kitty-violet/efinix-romantic-camera/THIRD_PARTY_NOTICES.md

# 第三方组件与权利说明

## 当前交付范围

本仓库按所有者要求公开归档指定 r15 complete 代码、模型/权重、运行数据、开发来源与 V9-P1 机械资料，供评审查阅。未自动套用 MIT、Apache-2.0、GPL、CERN-OHL 等统一许可证；公开访问不等同于取得所有内容的再分发或商用授权。

团队自研 HDL、机械设计和文档的权利范围由实际权利人确定。当前未提供全体作者授权或明确开源许可证，因此本仓库不代为作出开源授权声明。

## Efinix 器件原语和 IP

`fpga/project/native222.v` 是 r15 顶层网表，文件中带有 Efinity 2026.1.132 属性、Efinix 器件原语和 `pragma protect` 保护段；`five_style_name_osd.sv` 使用 `EFX_DPRAM10`。综合/仿真用 Sapphire 核及 `tests/vendor/efx_dsp48.v` 也按原包保留其厂家声明和保护内容。

受保护内容和厂家器件库适用其原有权利与许可条件。归档未解密、剥离或改写保护段，不把厂家 IP 改标为团队开源代码。使用者需自行具备合法的 Efinity/Titanium 工具与相应 IP 使用权限。

## I2C 源文件声明

r15 的 `i2c_master_bit_ctrl.v`、`i2c_master_byte_ctrl.v`、`i2c_master_defines.v` 同时带有 Intel 许可提示和 Richard Herveille/OpenCores 原始版权声明。本次逐字节保留这些文件及声明，不将它们改标为团队原创，也不为其添加统一开源授权。

## 机械设计来源记录

V9 参数和孔位报告引用板卡装配图、板卡设计说明、蓝牙模块资料及团队提供的照片/实测。引用信息保留于 CAD 参数和原始报告；相关厂家完整资料与竞赛 PDF 未整包上传。

原 CAD 生成脚本依赖 CadQuery、OCP 和 NumPy，但本仓库只包含项目脚本，不分发这些软件的安装文件或运行环境。它们分别适用自身许可证。

## 模型及开发来源

`fpga/network/`含团队选定五风格模型、量化参数、可读计算核和运行数据；`fpga/original_sources/`保留训练、导出和集成脚本的历史目录及声明。PyTorch、NumPy、Pillow 等依赖本体未分发，适用各自许可证。来源映射和哈希保留于 `fpga/SOURCE_ORIGINS.json`与各风格元数据。

## 公开与后续使用

本次仅按所有者要求变更仓库可见性，不为第三方代码、受保护 IP、模型素材或其他作者的作品新增授权。团队后续选定自研文件许可证时，应明确适用范围并继续保留第三方声明；更改可见性本身也不代表构建、板上验收或比赛申报已完成。
