kitty-violet/efinix-romantic-camera/docs/competition-checklist.md

# 赛题要求与本版本对照

核对日期：2026-11-04。当前归档：production-r15-complete（原包日期 2026-11-03）。此前“无 RISC-V、仅四个 HDL”的描述只适用于历史提交 `423d07a`，不再用于本版本。

依据团队已有《全国大学生嵌入式芯片与系统设计竞赛'2026 FPGA 创新设计赛道选题指南（易灵思）》共 21 页，平台说明见 PDF 第 3-4 页，赛题一“AI 赋能的「实时绘画」——风格化视频渲染系统”见 PDF 第 4-7 页。本次没有把厂家/组委会整份 PDF 复制到仓库，也没有用未经确认的网络规则替代本地版本。

“原说明记录”表示来源包中的声明；“源码可见”只表示阅读能确认的实现；“未提供”表示缺少材料或实测证据。本轮重新执行文件、工程引用、ROM、整数参数/参考向量、描述符及运行数据内存重建校验，没有执行训练、综合、HDL 仿真或实板测试。包内 PyTorch 和 Questa 检查结果是来源记录。

## 基础要求

| 赛题条目 | 当前仓库情况 | 提交/复现所需材料 |
| --- | --- | --- |
| Ti60F225 平台 | 工程 XML 指定 Ti60F225、I3、`ti60f225_oob_top`，已附引脚/外设/SDC | 实际板型、接线与构建实测记录 |
| MIPI CSI-2、SC431HAI、RAW 转 RGB/Resize，至少 640×480@30fps | 已附相机配置表、C 初始化、I2C 服务和图像路径/缩放逻辑 | 传感器/输入时序与采集速率实测 |
| DDR Ping-Pong 不丢帧 | 已附帧所有权、DDR 读写/DMA 和跨域源码 | 缓冲设计图、持续流量及掉帧测试 |
| 3×3/5×5 卷积、激活、BN/IN 近似硬件 | 已附 S4R1 逐层结构、3×3/DW/PW、ReLU、残差/重定量及 42 个可读核设计源；当前网络并无独立 BN/IN 或 5×5 节点 | 按正式评分口径说明算子/归一化映射，补功能仿真与综合证据；不将量化直接等同于 BN/IN |
| 总线访问 DDR 完成推理读写 | 已附 `control.h`、服务后端、DMA 和 C 调度 | 完整总线/地址图、带宽及端到端推理验证 |
| HDMI 至少 720p60 或 1080p30 | 源码时序 2200×1125、74.25MHz，对应 1080p30；风格计算为 720p，并非 HDMI30 即 AI30 | 本版输出时序、兼容性与稳定性实测 |
| RISC-V C 驱动完成相机初始化、权重加载、任务调度/中断 | **已新增官方 Sapphire 核、C 相机配置、目录/CRC 校验、装载调度与中断处理源码** | 对应生产 Flash 数据、固件/位流版本和实板运行证据 |
| 原图/风格图对比或按键切换 | 原包说明六模式、全半屏；源码有视图事件和原始/缩放路径切换 | 实际视图布局、操作与对比录像 |
| 实时 FPS，640×480 稳定 15fps 以上 | 有 FPS 显示相关逻辑，未附 r15 指定条件的帧率测量 | 分辨率、窗口、计数口径明确的实测；旧版 17.1 FPS 不直接复用 |

## 高阶挑战

| 赛题条目 | 当前仓库情况 | 需要补充 |
| --- | --- | --- |
| 至少两套网络权重，动态切换，不重配 FPGA | 五套独立 checkpoint/整数权重及六槽目录已附，C 支持驻留与切换；第六槽为原图 bypass，不是独立 CNN | 匹配位流和数据区、实际动态切换验收 |
| 切换延迟低于 100ms，切换不丢帧 | C 先排空再准备/恢复，原包称 r15 使用 16 支模式控制缓冲；无延迟实测 | 同步触发与输出的测量记录 |
| 1280×720@30fps 或更高处理吞吐 | 没有本版测量结果，不能据逻辑时钟或 HDMI 时序宣称 AI 吞吐 | r15 吞吐、延迟与稳定性数据 |
| 小于 500KB 网络、结构图、参数量表 | 已附逐层结构/连接表和参数表；每风格 4035 参数，checkpoint 28,519B，整数系数 5708B，驻留布局 20,480B | 注明统计是否含量化元数据/调度程序，补正式报告图及精度证据；程序大小不混作网络权重 |
| 对照标准网络的 PSNR/SSIM、推理延迟 | 未提供 | 数据集、评估脚本、指标和对比口径 |
| 创意交互及附加展示视频 | 有 BLE/按键事件、中文 OSD 和全半屏控制源码；无 APK/视频 | 手机控制演示、协议/应用版本及运行录像 |

r15 已有 RISC-V、工程配置、模型/可读核和运行数据，相应材料缺项已解除；数据区来源仍标记未板验，且没有最终位流。源码齐备和引用正确不能替代构建/性能验收。V9 外壳继续原样保留，其历史数值检查不等同于实物打印验收。

## GitHub 与评审访问

前次阅读的本地易灵思选题指南和总赛题指南中未找到“必须公开 GitHub 仓库”的明确条款；本次**按仓库所有者明确要求改为公开**，供评委直接查看，而非推定比赛条款。具体比赛平台的链接字段、报告和视频要求仍以团队收到的正式提交说明为准。

公开入口：`https://github.com/kitty-violet/efinix-romantic-camera`。浏览和克隆不再需要邀请；写入与管理权限仍受 GitHub 权限控制。公开不代表重新许可厂商受保护 IP，原版权和保护段保持不变。

建议准备的材料和当前缺项见[交接与提交](submission.md)。本表是一份依据已交付材料的对照，不代表比赛合规认证，也不会把缺失实现写成已完成。
