kitty-violet/efinix-romantic-camera/mechanical/enclosure_v9/04_核对与源文件/打印件安装孔中心.csv

用途 | 编号 | X_mm | Y_mm | Z_mm | 通孔直径_mm | 轴向
主板柱 | H1 | -47 | 31 | 78 | 3.4 | Z
主板柱 | H2 | 47 | 31 | 78 | 3.4 | Z
主板柱 | H3 | 47 | 105 | 78 | 3.4 | Z
主板柱 | H4 | -41.52536 | 101.01508000000001 | 78 | 3.4 | Z
主板柱 | H5 | -11.806339999999999 | 101.01508000000001 | 78 | 3.4 | Z
摄像头安装面 | C1 | -10.5 | 184 | -7 | 2.6 | Y
摄像头安装面 | C2 | -10.5 | 184 | 7 | 2.6 | Y
摄像头安装面 | C3 | 10.5 | 184 | -7 | 2.6 | Y
摄像头安装面 | C4 | 10.5 | 184 | 7 | 2.6 | Y
前后框连接 | F1 | -175.0 | 15 | -115.0 | 3.4 | Y
前后框连接 | F2 | -175.0 | 15 | 115.0 | 3.4 | Y
前后框连接 | F3 | 175.0 | 15 | -115.0 | 3.4 | Y
前后框连接 | F4 | 175.0 | 15 | 115.0 | 3.4 | Y
