kitty-violet/efinix-romantic-camera/mechanical/enclosure_v9/03_三维核对/V9确认稿_含电子件示意.png

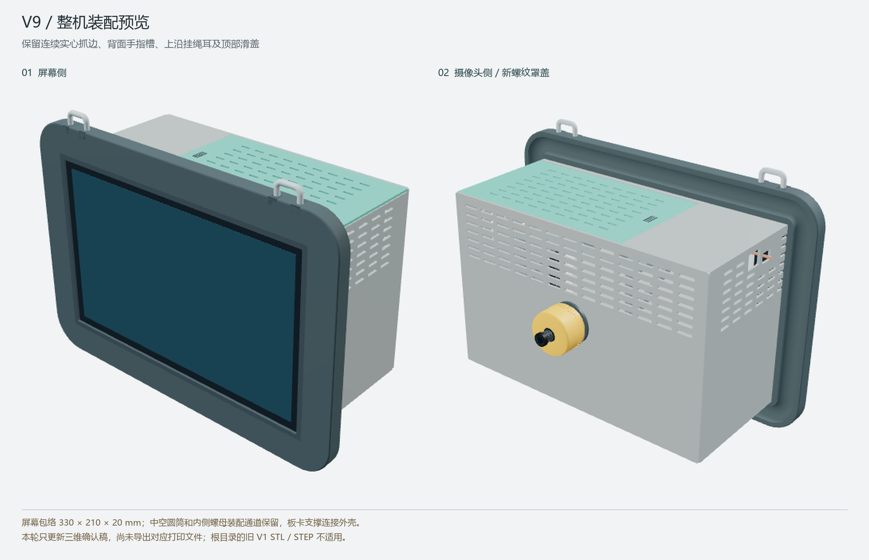
mechanical/enclosure_v9/03_三维核对/V9确认稿_含电子件示意.png
