kitty-violet/efinix-romantic-camera/mechanical/enclosure_v9/04_核对与源文件/主板原图孔位核对.png

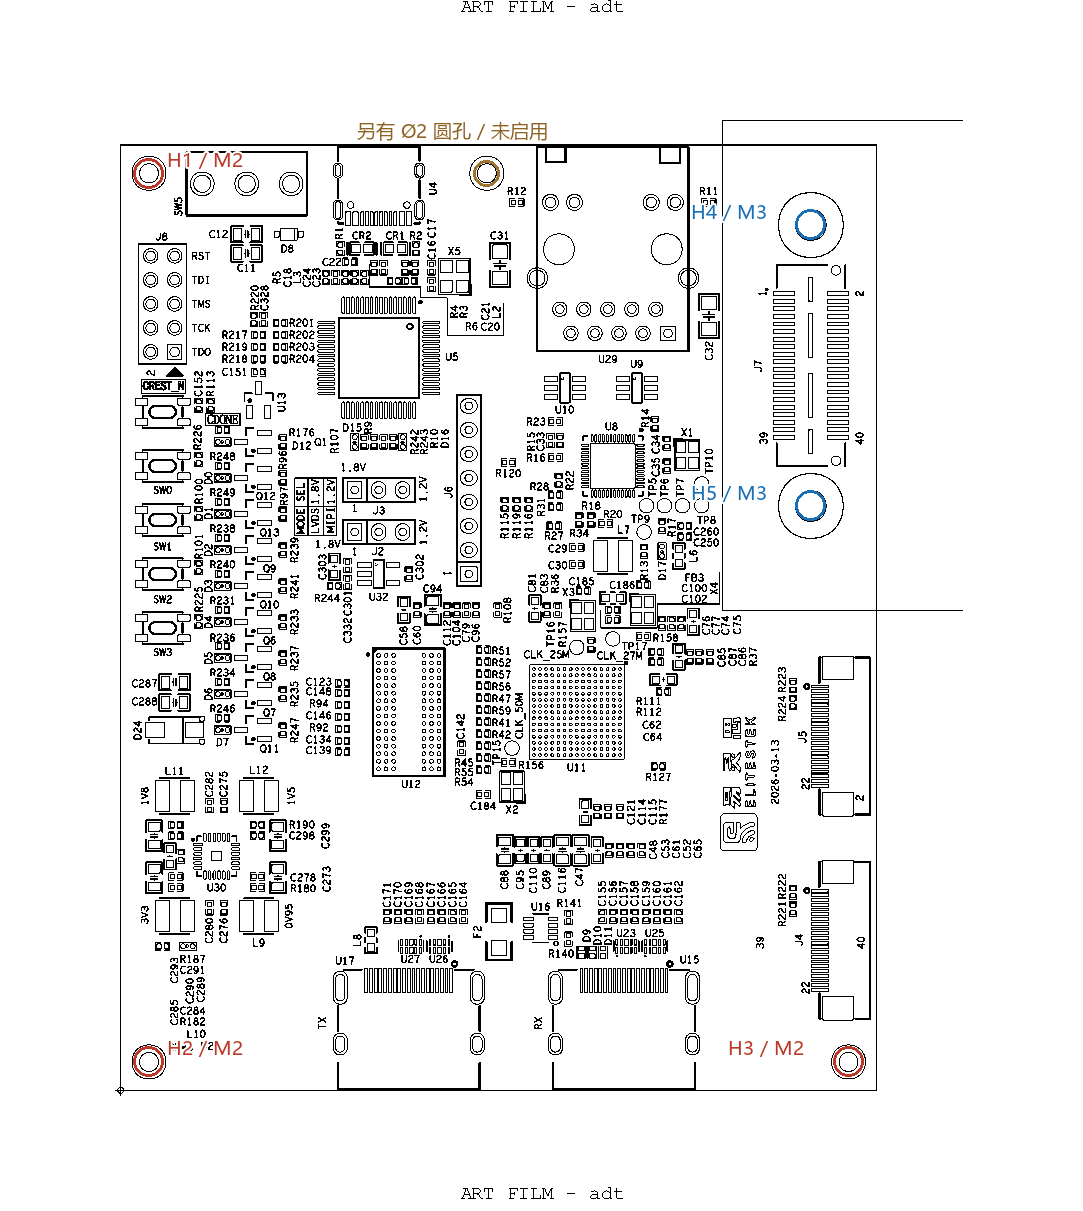
mechanical/enclosure_v9/04_核对与源文件/主板原图孔位核对.png
