kitty-violet/efinix-romantic-camera/fpga/project/outflow/ti60f225_oob.pinout.csv

# Efinity Pinout Report
# Version: 2026.1.132
# Date: 2026-11-01 20:18
# Copyright (C) 2013 - 2026 Efinix Inc. All rights reserved.
# Device: Ti60F225
# Package status: final
# Project: ti60f225_oob
# Configuration mode: active (x1)
Pin Number | Pin Name | Signal Name | Direction | Bank | I/O Bank Voltage | I/O Standard | Pull Type | Function
A1 | GND |  | Power |  |  |  |  | Ground
A2 | GPIOL_N_18 |  |  | 1B | 1.8 V |  |  | User IO/PLL_CLKIN
A3 | GPIOL_03 | view_key_n | Input | TL | 3.3 V | 3.3 V LVCMOS | weak pullup | User IO
A4 | GPIOL_09 | ble_uart_rx | Input | TL | 3.3 V | 3.3 V LVCMOS | weak pullup | User IO
A5 | GPIOT_P_03 |  |  | 2A | 1.2 V |  |  | User IO/MIPI_GCLK/MIPI_RCLK
A6 | GPIOT_N_03 |  |  | 2A | 1.2 V |  |  | User IO/MIPI_GCLK/MIPI_RCLK
A7 | GPIOT_N_06 | cam_d2.N | Input | 2A | 1.2 V |  |  | User IO
A8 | GPIOT_N_07_CLK4_N | cam_d0.N | Input | 2A | 1.2 V |  |  | User IO/GCLK/RCLK
A9 | GPIOT_N_11 | cam_d3.N | Input | 2B | 1.2 V |  |  | User IO
A10 | GPIOT_P_14 |  |  | 2B | 1.2 V |  |  | User IO/MIPI_GCLK
A11 | GPIOT_P_17_PLLIN1 |  |  | 2B | 1.2 V |  |  | User IO/PLL_CLKIN
A12 | GPIOR_13 |  | Input | TR | 3.3 V |  | weak pullup | User IO
A13 | GPIOR_12 |  | Input | TR | 3.3 V |  | weak pullup | User IO
A14 | GPIOR_19 |  | Input | TR | 3.3 V |  | weak pullup | User IO
A15 | GND |  | Power |  |  |  |  | Ground
B1 | GPIOL_P_17_EXTFB |  |  | 1B | 1.8 V |  |  | User IO/PLL_EXTFB
B2 | GPIOL_P_18_PLLIN0 |  |  | 1B | 1.8 V |  |  | User IO/PLL_CLKIN
B3 | GPIOL_04 |  | Input | TL | 3.3 V |  | weak pullup | User IO
B4 | VCCIO33_TL |  | Power | TL | 3.3 V |  |  | VCCIO Power
B5 | GPIOL_10 |  | Input | TL | 3.3 V |  | weak pullup | User IO
B6 | GPIOT_P_01 |  |  | 2A | 1.2 V |  |  | User IO
B7 | GPIOT_P_06 | cam_d2.P | Input | 2A | 1.2 V |  |  | User IO
B8 | GPIOT_P_07_CLK4_P | cam_d0.P | Input | 2A | 1.2 V |  |  | User IO/GCLK/RCLK
B9 | GPIOT_P_11 | cam_d3.P | Input | 2B | 1.2 V |  |  | User IO
B10 | GPIOT_N_14 |  |  | 2B | 1.2 V |  |  | User IO/MIPI_GCLK
B11 | GPIOT_N_17 |  |  | 2B | 1.2 V |  |  | User IO/PLL_CLKIN
B12 | GPIOR_15 |  | Input | TR | 3.3 V |  | weak pullup | User IO
B13 | VCCIO33_TR |  | Power | TR | 3.3 V |  |  | VCCIO Power
B14 | GPIOR_18 | io_cam_sda | Bidirectional | TR | 3.3 V | 3.3 V LVCMOS | weak pullup | User IO
B15 | REF_RES_3A |  | Input | 3A | 1.8 V
C1 | GPIOL_N_16 |  |  | 1B | 1.8 V |  |  | User IO/MIPI_GCLK/MIPI_RCLK
C2 | GPIOL_N_17 |  |  | 1B | 1.8 V |  |  | User IO/PLL_EXTFB
C3 | GPIOL_06 |  | Input | TL | 3.3 V |  | weak pullup | User IO
C4 | GPIOL_07 | service_key_n | Input | TL | 3.3 V | 3.3 V LVCMOS | weak pullup | User IO
C5 | GPIOL_11_PLLIN2 | ble_uart_tx | Output | TL | 3.3 V | 3.3 V LVCMOS |  | User IO/PLL_CLKIN
C6 | GPIOT_N_01 |  |  | 2A | 1.2 V |  |  | User IO
C7 | VCCIO2A |  | Power | 2A | 1.2 V |  |  | VCCIO Power
C8 | GPIOT_P_10_CLK7_P | cam_d1.P | Input | 2B | 1.2 V |  |  | User IO/GCLK/RCLK
C9 | GPIOT_N_10_CLK7_N | cam_d1.N | Input | 2B | 1.2 V |  |  | User IO/GCLK/RCLK
C10 | GPIOT_P_13 |  |  | 2B | 1.2 V |  |  | User IO/VREF
C11 | VCCIO2B |  | Power | 2B | 1.2 V |  |  | VCCIO Power
C12 | GPIOR_16 | o_cam_rst_p | Output | TR | 3.3 V | 3.3 V LVCMOS |  | User IO
C13 | GPIOR_P_17 |  |  | 3A | 1.8 V |  |  | User IO/MIPI_GCLK/MIPI_RCLK
C14 | GPIOR_P_19_PLLIN0 |  |  | 3A | 1.8 V |  |  | User IO/PLL_CLKIN
C15 | GPIOR_N_19 |  |  | 3A | 1.8 V |  |  | User IO/PLL_CLKIN
D1 | GPIOL_P_16 |  |  | 1B | 1.8 V |  |  | User IO/MIPI_GCLK/MIPI_RCLK
D2 | VCCIO1B |  | Power | 1B | 1.8 V |  |  | VCCIO Power
D3 | GND |  | Power |  |  |  |  | Ground
D4 | VCCAUX |  | Power | 4B | 1.5 V
D5 | GPIOT_N_00 |  |  | 2A | 1.2 V |  |  | User IO/PLL_CLKIN
D6 | VCCIO2A |  | Power | 2A | 1.2 V |  |  | VCCIO Power
D7 | GPIOT_N_05 |  |  | 2A | 1.2 V |  |  | User IO
D8 | GPIOT_N_09_CLK6_N | cam_ck.N | Input | 2B | 1.2 V |  |  | User IO/GCLK/MIPI_GCLK/RCLK/MIPI_RCLK
D9 | VCCIO2B |  | Power | 2B | 1.2 V |  |  | VCCIO Power
D10 | GPIOT_N_13 |  |  | 2B | 1.2 V |  |  | User IO
D11 | REF_RES_2B |  | Input | 2B | 1.2 V
D12 | GPIOR_20 | io_cam_scl | Bidirectional | TR | 3.3 V | 3.3 V LVCMOS | weak pullup | User IO
D13 | GPIOR_N_17 |  |  | 3A | 1.8 V |  |  | User IO/MIPI_GCLK/MIPI_RCLK
D14 | GPIOR_N_18 |  |  | 3A | 1.8 V |  |  | User IO
D15 | GPIOR_P_18 |  |  | 3A | 1.8 V |  |  | User IO
E1 | GPIOL_P_15_NSTATUS |  |  | 1B | 1.8 V |  |  | User IO/VREF/Configuration
E2 | GPIOL_N_15_TEST_N |  |  | 1B | 1.8 V |  |  | User IO/Configuration
E3 | GPIOL_N_13_CBSEL1 |  |  | 1B | 1.8 V |  |  | User IO
E4 | REF_RES_1B |  | Input | 1B | 1.8 V
E5 | VCCA_TL |  | Power |  |  |  |  | 0.95 V PLL Power
E6 | GPIOT_P_00_PLLIN1 |  |  | 2A | 1.2 V |  |  | User IO/PLL_CLKIN/VREF
E7 | GPIOT_P_05 |  |  | 2A | 1.2 V |  |  | User IO
E8 | GPIOT_P_09_CLK6_P | cam_ck.P | Input | 2B | 1.2 V |  |  | User IO/GCLK/MIPI_GCLK/RCLK/MIPI_RCLK
E9 | GPIOT_N_12 |  |  | 2B | 1.2 V |  |  | User IO
E10 | GPIOT_P_16_EXTFB |  |  | 2B | 1.2 V |  |  | User IO/PLL_EXTFB
E11 | VCCAUX |  | Power | 4B | 1.5 V
E12 | GPIOR_N_15 |  |  | 3A | 1.8 V |  |  | User IO
E13 | VCC |  | Power |  |  |  |  | 0.95 V VCC Power
E14 | GPIOR_N_16 |  |  | 3A | 1.8 V |  |  | User IO
E15 | GPIOR_P_16 |  |  | 3A | 1.8 V |  |  | User IO
F1 | GPIOL_P_14 |  |  | 1B | 1.8 V |  |  | User IO
F2 | GPIOL_N_14 |  |  | 1B | 1.8 V |  |  | User IO
F3 | GPIOL_P_13_CBSEL0 |  |  | 1B | 1.8 V |  |  | User IO
F4 | VCCIO1B |  | Power | 1B | 1.8 V |  |  | VCCIO Power
F5 | GPIOL_N_11 |  |  | 1B | 1.8 V |  |  | User IO
F6 | REF_RES_2A |  | Input | 2A | 1.2 V
F7 | GPIOT_P_04 |  |  | 2A | 1.2 V |  |  | User IO
F8 | GPIOT_N_04 |  |  | 2A | 1.2 V |  |  | User IO
F9 | GPIOT_P_12 |  |  | 2B | 1.2 V |  |  | User IO
F10 | GPIOT_N_16 |  |  | 2B | 1.2 V |  |  | User IO/PLL_EXTFB
F11 | GPIOR_N_14 |  |  | 3A | 1.8 V |  |  | User IO
F12 | GPIOR_P_15 |  |  | 3A | 1.8 V |  |  | User IO
F13 | GPIOR_N_12 | tmds_tx_data2.N | Output | 3A | 1.8 V |  |  | User IO
F14 | VCCIO3A |  | Power | 3A | 1.8 V |  |  | VCCIO Power
F15 | GPIOR_N_13 | tmds_tx_data0.N | Output | 3A | 1.8 V |  |  | User IO
G1 | GPIOL_N_09_CLK2_N |  |  | 1B | 1.8 V |  |  | User IO/GCLK/MIPI_GCLK/RCLK/MIPI_RCLK
G2 | GPIOL_N_10_CLK3_N |  |  | 1B | 1.8 V |  |  | User IO/GCLK/RCLK
G3 | GPIOL_P_12 | led[2].P | Output | 1B | 1.8 V | 1.8 V LVCMOS |  | User IO
G4 | GPIOL_N_12 |  |  | 1B | 1.8 V |  |  | User IO
G5 | GPIOL_P_11 |  |  | 1B | 1.8 V |  |  | User IO
G6 | VQPS_GND |  | Power
G7 | VCC |  | Power |  |  |  |  | 0.95 V VCC Power
G8 | GND |  | Power |  |  |  |  | Ground
G9 | VCC |  | Power |  |  |  |  | 0.95 V VCC Power
G10 | VCCA_TR |  | Power |  |  |  |  | 0.95 V PLL Power
G11 | GPIOR_P_14 |  |  | 3A | 1.8 V |  |  | User IO
G12 | VCCIO3A |  | Power | 3A | 1.8 V |  |  | VCCIO Power
G13 | GPIOR_P_12 | tmds_tx_data2.P | Output | 3A | 1.8 V |  |  | User IO
G14 | GPIOR_N_11_CLK8_N | tmds_tx_data1.N | Output | 3A | 1.8 V |  |  | User IO/GCLK/RCLK
G15 | GPIOR_P_13 | tmds_tx_data0.P | Output | 3A | 1.8 V |  |  | User IO/VREF
H1 | GPIOL_P_09_CLK2_P |  |  | 1B | 1.8 V |  |  | User IO/GCLK/MIPI_GCLK/RCLK/MIPI_RCLK
H2 | GPIOL_P_10_CLK3_P | CLK_27M.P | Input | 1B | 1.8 V | 1.8 V LVCMOS |  | User IO/GCLK/RCLK/Configuration
H3 | GPIOL_N_08_CLK1_N |  |  | 1A | 1.8 V |  |  | User IO/GCLK/RCLK/Configuration
H4 | GPIOL_N_04_CDI3 |  |  | 1A | 1.8 V |  |  | User IO
H5 | GPIOL_P_04_CDI2 |  |  | 1A | 1.8 V |  |  | User IO/VREF
H6 | VCC |  | Power |  |  |  |  | 0.95 V VCC Power
H7 | GND |  | Power |  |  |  |  | Ground
H8 | VCC |  | Power |  |  |  |  | 0.95 V VCC Power
H9 | GND |  | Power |  |  |  |  | Ground
H10 | GPIOR_P_08_CLK11_P | ddr_addr[10].P | Output | 3B | 1.5 V | 1.5 V SSTL |  | User IO/GCLK/RCLK
H11 | GPIOR_N_08_CLK11_N | ddr_reset_n.N | Output | 3B | 1.5 V | 1.5 V SSTL |  | User IO/GCLK/RCLK
H12 | GPIOR_N_10_CLK9_N | tmds_tx_clk.N | Output | 3A | 1.8 V |  |  | User IO/GCLK/MIPI_GCLK/RCLK/MIPI_RCLK
H13 | GPIOR_P_10_CLK9_P | tmds_tx_clk.P | Output | 3A | 1.8 V |  |  | User IO/GCLK/MIPI_GCLK/RCLK/MIPI_RCLK
H14 | GPIOR_P_11_CLK8_P | tmds_tx_data1.P | Output | 3A | 1.8 V |  |  | User IO/GCLK/RCLK
H15 | GPIOR_N_09_CLK10_N | ddr_ck.N | Output | 3B | 1.5 V | 1.5 V Differential SSTL |  | User IO/GCLK/RCLK
J1 | GPIOL_N_07_CLK0_N |  |  | 1A | 1.8 V |  |  | User IO/GCLK/RCLK
J2 | GPIOL_P_08_CLK1_P | CLK_25M.P | Input | 1A | 1.8 V | 1.8 V LVCMOS |  | User IO/GCLK/RCLK
J3 | GPIOL_N_05 |  |  | 1A | 1.8 V |  |  | User IO
J4 | VCCIO1A |  | Power | 1A | 1.8 V |  |  | VCCIO Power
J5 | CRESET_N |  | Input | 1A | 1.8 V |  |  | Configuration
J6 | GND |  | Power |  |  |  |  | Ground
J7 | VCC |  | Power |  |  |  |  | 0.95 V VCC Power
J8 | GND |  | Power |  |  |  |  | Ground
J9 | VCC |  | Power |  |  |  |  | 0.95 V VCC Power
J10 | GPIOR_N_03_CDI27 | ddr_addr[11].N | Output | 3B | 1.5 V | 1.5 V SSTL |  | User IO
J11 | VCCIO3B |  | Power | 3B | 1.5 V |  |  | VCCIO Power
J12 | GPIOR_N_04_CDI29 | ddr_addr[13].N | Output | 3B | 1.5 V | 1.5 V SSTL |  | User IO
J13 | GPIOR_N_06_CDI21 | ddr_addr[7].N | Output | 3B | 1.5 V | 1.5 V SSTL |  | User IO
J14 | GPIOR_N_07 | ddr_addr[9].N | Output | 3B | 1.5 V | 1.5 V SSTL |  | User IO
J15 | GPIOR_P_09_CLK10_P | ddr_ck.P | Output | 3B | 1.5 V | 1.5 V Differential SSTL |  | User IO/GCLK/RCLK
K1 | GPIOL_P_07_CLK0_P |  |  | 1A | 1.8 V |  |  | User IO/GCLK/RCLK
K2 | GPIOL_N_06 |  |  | 1A | 1.8 V |  |  | User IO
K3 | GPIOL_P_06 |  |  | 1A | 1.8 V |  |  | User IO
K4 | GPIOL_P_05 |  |  | 1A | 1.8 V |  |  | User IO
K5 | REF_RES_1A |  | Input | 1A | 1.8 V
K6 | GPIOB_N_04 | ddr_addr[3].N | Output | 4B | 1.5 V | 1.5 V SSTL |  | User IO
K7 | GPIOB_P_09_CLK13_P | verf0.P | Input | 4A | 1.5 V | 1.5 V SSTL |  | User IO/GCLK/MIPI_GCLK/RCLK/MIPI_RCLK/VREF/Configuration
K8 | GPIOB_P_11_CDI10 | ddr_addr[5].P | Output | 4A | 1.5 V | 1.5 V SSTL |  | User IO
K9 | GPIOB_N_11_CDI11 |  |  | 4A | 1.5 V |  |  | User IO
K10 | GPIOR_P_03_CDI26 | ddr_addr[6].P | Output | 3B | 1.5 V | 1.5 V SSTL |  | User IO
K11 | GPIOR_N_00_CDI22 | ddr_addr[8].N | Output | 3B | 1.5 V | 1.5 V SSTL |  | User IO/PLL_CLKIN
K12 | GPIOR_P_04_CDI28 | ddr_addr[2].P | Output | 3B | 1.5 V | 1.5 V SSTL |  | User IO
K13 | GPIOR_P_06_CDI20 |  |  | 3B | 1.5 V |  |  | User IO
K14 | GPIOR_P_07 | ddr_ba[2].P | Output | 3B | 1.5 V | 1.5 V SSTL |  | User IO
K15 | GPIOR_N_05_CDI31 | ddr_addr[0].N | Output | 3B | 1.5 V | 1.5 V SSTL |  | User IO
L1 | GPIOL_N_03_CDI1 | flash_miso.N | Input | 1A | 1.8 V | 1.8 V LVCMOS |  | User IO/Configuration
L2 | VCCIO1A |  | Power | 1A | 1.8 V |  |  | VCCIO Power
L3 | CDONE |  | Bidirectional | 1A | 1.8 V |  |  | Configuration
L4 | VCCAUX |  | Power | 4B | 1.5 V
L5 | VCCA_BL |  | Power |  |  |  |  | 0.95 V PLL Power
L6 | GPIOB_P_04_SSU_N | verf1.P | Input | 4B | 1.5 V | 1.5 V SSTL |  | User IO/VREF/Configuration
L7 | GPIOB_N_06_CDI9 | ddr_ba[0].N | Output | 4B | 1.5 V | 1.5 V SSTL |  | User IO
L8 | GPIOB_N_09_CLK13_N | ddr_cke[0].N | Output | 4A | 1.5 V | 1.5 V SSTL |  | User IO/GCLK/MIPI_GCLK/RCLK/MIPI_RCLK
L9 | GPIOB_N_10_CLK12_N | ddr_ba[1].N | Output | 4A | 1.5 V | 1.5 V SSTL |  | User IO/GCLK/RCLK
L10 | VCCA_BR |  | Power |  |  |  |  | 0.95 V PLL Power
L11 | GPIOR_P_00_PLLIN0 | ddr_addr[4].P | Output | 3B | 1.5 V | 1.5 V SSTL |  | User IO/PLL_CLKIN
L12 | GPIOR_P_01_EXTFB | ddr_addr[12].P | Output | 3B | 1.5 V | 1.5 V SSTL |  | User IO/PLL_EXTFB
L13 | GPIOR_N_01_CDI23 | ddr_addr[1].N | Output | 3B | 1.5 V | 1.5 V SSTL |  | User IO/PLL_EXTFB
L14 | VCCIO3B |  | Power | 3B | 1.5 V |  |  | VCCIO Power
L15 | GPIOR_P_05_CDI30 | ddr_we_n.P | Output | 3B | 1.5 V | 1.5 V SSTL |  | User IO/VREF
M1 | GPIOL_P_03_CDI0 | flash_mosi.P | Output | 1A | 1.8 V | 1.8 V LVCMOS |  | User IO/Configuration
M2 | GPIOL_N_02_CSO |  |  | 1A | 1.8 V |  |  | User IO/MIPI_GCLK/MIPI_RCLK/Configuration
M3 | VCC |  | Power |  |  |  |  | 0.95 V VCC Power
M4 | TDO |  | Output | BL | 3.3 V |  |  | Configuration
M5 | REF_RES_4B |  | Input | 4B | 1.5 V
M6 | GPIOB_N_03_CDI7 | ddr_dq[9].N | Bidirectional | 4B | 1.5 V | 1.5 V SSTL |  | User IO/MIPI_GCLK/MIPI_RCLK
M7 | GPIOB_P_06_CDI8 | ddr_odt[0].P | Output | 4B | 1.5 V | 1.5 V SSTL |  | User IO
M8 | GPIOB_N_08_CLK14_N | ddr_cs_n[0].N | Output | 4B | 1.5 V | 1.5 V SSTL |  | User IO/GCLK/RCLK
M9 | GPIOB_P_10_CLK12_P | ddr_dm[0].P | Output | 4A | 1.5 V | 1.5 V SSTL |  | User IO/GCLK/RCLK
M10 | GPIOB_N_13_CDI15 | ddr_dq[1].N | Bidirectional | 4A | 1.5 V | 1.5 V SSTL |  | User IO
M11 | VCCAUX |  | Power | 4B | 1.5 V
M12 | REF_RES_3B |  | Input | 3B | 1.5 V
M13 | GND |  | Power |  |  |  |  | Ground
M14 | GPIOR_P_02_CDI24 | ddr_ras_n.P | Output | 3B | 1.5 V | 1.5 V SSTL |  | User IO/MIPI_GCLK/MIPI_RCLK
M15 | GPIOR_N_02_CDI25 | ddr_cas_n.N | Output | 3B | 1.5 V | 1.5 V SSTL |  | User IO/MIPI_GCLK/MIPI_RCLK
N1 | GPIOL_N_01_CCK | flash_sclk.N | Output | 1A | 1.8 V | 1.8 V LVCMOS |  | User IO/Configuration
N2 | GPIOL_P_02_CSI | led[3].P | Output | 1A | 1.8 V | 1.8 V LVCMOS |  | User IO/MIPI_GCLK/MIPI_RCLK/Configuration
N3 | TMS |  | Input | BL | 3.3 V |  |  | Configuration
N4 | TCK |  | Input | BL | 3.3 V |  |  | Configuration
N5 | VCCIO4B |  | Power | 4B | 1.5 V |  |  | VCCIO Power
N6 | GPIOB_P_03_CDI6 | ddr_dq[13].P | Bidirectional | 4B | 1.5 V | 1.5 V SSTL |  | User IO/MIPI_GCLK/MIPI_RCLK
N7 | VCCIO4B |  | Power | 4B | 1.5 V |  |  | VCCIO Power
N8 | GPIOB_P_08_CLK14_P | ddr_dq[11].P | Bidirectional | 4B | 1.5 V | 1.5 V SSTL |  | User IO/GCLK/RCLK
N9 | VCCIO4A |  | Power | 4A | 1.5 V |  |  | VCCIO Power
N10 | GPIOB_P_13_CDI14 | ddr_dq[5].P | Bidirectional | 4A | 1.5 V | 1.5 V SSTL |  | User IO
N11 | VCCIO4A |  | Power | 4A | 1.5 V |  |  | VCCIO Power
N12 | REF_RES_4A |  | Input | 4A | 1.5 V
N13 | GPIOR_24 | led[1] | Output | BR | 3.3 V | 3.3 V LVCMOS |  | User IO
N14 | GPIOR_21 | style_key_n | Input | BR | 3.3 V | 3.3 V LVCMOS | weak pullup | User IO
N15 | VCCIO33_BR |  | Power | BR | 3.3 V |  |  | VCCIO Power
P1 | GPIOL_P_01_SSL_N | flash_cs_n.P | Output | 1A | 1.8 V | 1.8 V LVCMOS |  | User IO/Configuration
P2 | GPIOL_P_00_PLLIN0 |  |  | 1A | 1.8 V |  |  | User IO/PLL_CLKIN
P3 | TDI |  | Input | BL | 3.3 V |  |  | Configuration
P4 | VCCIO33_BL |  | Power | BL | 3.3 V |  |  | VCCIO Power
P5 | GPIOB_N_00 | ddr_dq[15].N | Bidirectional | 4B | 1.5 V | 1.5 V SSTL |  | User IO/PLL_CLKIN
P6 | GPIOB_N_01 | ddr_dq[12].N | Bidirectional | 4B | 1.5 V | 1.5 V SSTL |  | User IO/PLL_EXTFB
P7 | GPIOB_N_02_CDI5 | ddr_dqs[1].N | Bidirectional | 4B | 1.5 V | 1.5 V Differential SSTL |  | User IO
P8 | GPIOB_N_07_CLK15_N | ddr_dq[8].N | Bidirectional | 4B | 1.5 V | 1.5 V SSTL |  | User IO/GCLK/RCLK
P9 | GPIOB_N_12_CDI13 | ddr_dq[3].N | Bidirectional | 4A | 1.5 V | 1.5 V SSTL |  | User IO
P10 | GPIOB_N_14_CDI17 | ddr_dq[6].N | Bidirectional | 4A | 1.5 V | 1.5 V SSTL |  | User IO/MIPI_GCLK
P11 | GPIOB_P_17_PLLIN1 | ddr_dq[7].P | Bidirectional | 4A | 1.5 V | 1.5 V SSTL |  | User IO/PLL_CLKIN
P12 | GPIOB_N_17 | ddr_dq[4].N | Bidirectional | 4A | 1.5 V | 1.5 V SSTL |  | User IO/PLL_CLKIN
P13 | GPIOR_27 | led[0] | Output | BR | 3.3 V | 3.3 V LVCMOS |  | User IO
P14 | GPIOR_22 | i_arstn | Input | BR | 3.3 V | 3.3 V LVCMOS | weak pullup | User IO
P15 | GPIOR_25 |  | Input | BR | 3.3 V |  | weak pullup | User IO
R1 | GND |  | Power |  |  |  |  | Ground
R2 | GPIOL_N_00 |  |  | 1A | 1.8 V |  |  | User IO/PLL_CLKIN
R3 | GPIOL_01 |  | Input | BL | 3.3 V |  | weak pullup | User IO
R4 | GPIOL_02 |  | Input | BL | 3.3 V |  | weak pullup | User IO
R5 | GPIOB_P_00_PLLIN1 | ddr_dq[14].P | Bidirectional | 4B | 1.5 V | 1.5 V SSTL |  | User IO/PLL_CLKIN
R6 | GPIOB_P_01_EXTFB | ddr_dq[10].P | Bidirectional | 4B | 1.5 V | 1.5 V SSTL |  | User IO/PLL_EXTFB
R7 | GPIOB_P_02_CDI4 | ddr_dqs[1].P | Bidirectional | 4B | 1.5 V | 1.5 V Differential SSTL |  | User IO
R8 | GPIOB_P_07_CLK15_P | ddr_dm[1].P | Output | 4B | 1.5 V | 1.5 V SSTL |  | User IO/GCLK/RCLK
R9 | GPIOB_P_12_CDI12 | ddr_dq[0].P | Bidirectional | 4A | 1.5 V | 1.5 V SSTL |  | User IO
R10 | GPIOB_P_14_CDI16 | ddr_dq[2].P | Bidirectional | 4A | 1.5 V | 1.5 V SSTL |  | User IO/MIPI_GCLK
R11 | GPIOB_N_15_CDI19 | ddr_dqs[0].N | Bidirectional | 4A | 1.5 V | 1.5 V Differential SSTL |  | User IO
R12 | GPIOB_P_15_CDI18 | ddr_dqs[0].P | Bidirectional | 4A | 1.5 V | 1.5 V Differential SSTL |  | User IO
R13 | GPIOR_29_PLLIN2 |  | Input | BR | 3.3 V |  | weak pullup | User IO/PLL_CLKIN
R14 | GPIOR_28 |  | Input | BR | 3.3 V |  | weak pullup | User IO
R15 | GND |  | Power |  |  |  |  | Ground
