kitty-violet/efinix-romantic-camera/(list of files, cad)

Other CAD files:
mechanical/enclosure_v9/01_正式打印零件/06_IO_spacer_7p4mm.stp
mechanical/enclosure_v9/02_先打螺纹试配件/T2_female_thread_fit.stp
mechanical/enclosure_v9/整机装配_V9_P1.stp
mechanical/enclosure_v9/01_正式打印零件/02_rear_case_camera.stp
mechanical/enclosure_v9/02_先打螺纹试配件/T1_male_thread_fit.stp
mechanical/enclosure_v9/01_正式打印零件/03_sliding_lid.stp
mechanical/enclosure_v9/01_正式打印零件/01_front_frame_grip.stp
mechanical/enclosure_v9/01_正式打印零件/05_camera_spacer_1mm.stp
mechanical/enclosure_v9/01_正式打印零件/04_camera_screw_cap.stp
mechanical/enclosure_v9/01_正式打印零件/01_front_frame_grip.stl
mechanical/enclosure_v9/01_正式打印零件/02_rear_case_camera.stl
mechanical/enclosure_v9/01_正式打印零件/03_sliding_lid.stl
mechanical/enclosure_v9/01_正式打印零件/04_camera_screw_cap.stl
mechanical/enclosure_v9/01_正式打印零件/05_camera_spacer_1mm.stl
mechanical/enclosure_v9/01_正式打印零件/06_IO_spacer_7p4mm.stl
mechanical/enclosure_v9/02_先打螺纹试配件/T1_male_thread_fit.stl
mechanical/enclosure_v9/02_先打螺纹试配件/T2_female_thread_fit.stl
