kitty-violet/efinix-romantic-camera/mechanical/enclosure_v9/装配与五金说明.md

# 相机外壳 V9-P1

本包将已确认 V9 转成实体 CAD 和闭合 STL。日期 2026-10-28，单位 mm，比例 1:1。
文件适用于商家报价、工艺评审及首件试装；尚未做实物打印验证。

## 相对三维确认稿的装配落实

1. 前框、抓边和挂绳耳成为一个零件；后壳、托架、斜撑、安装柱和摄像头圆筒成为另一个零件。分界在抓边后表面 y=15，屏幕可从分开的前侧装入。
2. 抓边四角各增加一处 Ø3.4 螺丝孔和局部支承台，后壳对应增加带 M3 螺母窝的连接耳。连接耳位于抓边后侧，其四个孔中心为 x=±175、z=±115。屏幕占用的角部已让空。
3. 后壳内侧增加四处屏幕后沿定位台，位于主机包络外；将 20 mm 厚屏幕约束在前框挡边与后沿定位台之间。
4. 滑盖边缘改成能实际扣合的导轨、台阶和舌边，前后端各退让 0.3。右侧承托底板下移 0.75，给舌边留出空间。局部间隙约 0.225～0.30。
5. 旋盖保留 Ø16 镜头孔和 13 mm 前伸基准；实体采用同螺距、同相位的连续单头螺旋。入口做让空，外牙两端渐退。不是用水平圆环代替螺纹。
6. 相交的结构合并为单个实体。虚拟屏幕、电子板、金属件、排线和文字标记不导出为打印件。

## 零件数量

| 文件编号 | 每套数量 | 零件 |
| --- | ---: | --- |
| 01_front_frame_grip | 1 | 前框、实心抓边、背面手指槽、两个上沿挂绳耳 |
| 02_rear_case_camera | 1 | 后壳、托架、斜撑、五根柱、摄像头外螺纹圆筒 |
| 03_sliding_lid | 1 | 顶部散热滑盖 |
| 04_camera_screw_cap | 1 | 摄像头内螺纹罩盖 |
| 05_camera_spacer_1mm | 4 | 外径3.6、孔径1.8、厚1；可用同规格金属隔套替换 |
| 06_IO_spacer_7p4mm | 2 | 外径5.4、孔径3.4、高7.4；可用同规格金属隔套替换 |

T1、T2 各一件是先期螺纹试配环，不装入整机。所有 .stp/.stl 是重复格式，按每行数量选一种格式打印。
单件文件已平移至坐标非负，未自动旋转。完整装配 STEP 保留装配坐标；离线预览按清单中的平移量还原装配。

## 五金

下列长度与外形包络沿用设计值，采购或装配时应核对实物。打印件的孔均为通孔，未把这些小螺丝设计成攻丝孔。

| 用途 | 螺丝及数量 | 螺母/附件 |
| --- | --- | --- |
| 前框与后壳 | M3×30，4颗 | M3螺母4个，前端可配垫片；螺母窝对边5.9、轴向让空2.8 |
| 主板三个小孔 | M2×6，3颗 | M2螺母3个；PCB孔径2，打印柱通孔3.4 |
| 主板/IO两个大孔 | M3×16，2颗 | M3螺母2个，7.4mm隔套2个；PCB孔径3.25 |
| 摄像头 | M1.6×10，4颗 | M1.6螺母4个、外径4.5垫片4个、1mm隔套4个 |

摄像头板自身四孔 Ø2，壳体通孔 Ø2.6；不能把摄像头螺丝改成 M3。
原装配图还存在一个未分配的 Ø2 孔，本版保持此前确认的五点固定方案，没有增加第六根柱。
孔位来源图和坐标表附在核对目录。

## 装配顺序

1. 先用正式材料、工艺打印 T1/T2，确认能旋合；再试罩盖与圆筒配合。涉及收缩补偿时配对修订。
2. 后壳前侧保持敞开。摄像头圆形安装面朝外，PCB 位于中央，四个1mm隔套置于安装面与PCB之间。
3. 从摄像头外侧穿入四颗 M1.6 螺丝；从机身内侧经 Ø36 筒腔放入垫片和螺母并拧紧。此时不要装屏幕。
4. 排线从摄像头板下沿向下折回，穿过板下的14×3狭缝进入筒腔，连接主板J4。中间原排线孔已封实；圆筒外壁下侧没有出口。
5. 在五个主板柱窝内放对应M2/M3螺母，放主板、两个7.4mm隔套及IO板并固定。蓝牙固定关系沿用实物焊接，底部为托边支承。
6. 接屏幕HDMI和DC。HDMI插头接屏幕后主机下沿的HDMI口；DC由下沿黑色圆口接入，电源线穿后壳底板出口。按实物核对插头和弯线空间。
7. 从前框后侧放入屏幕，显示面朝前。将后壳套到屏幕后部主机外，四个屏幕后沿台接近屏幕背框。主板支撑不依赖屏幕承重。
8. 提前把四个M3螺母放入后壳四角螺母窝；合上前框与后壳，穿入四颗M3×30螺丝固定。确认屏幕不受顶压、排线没有夹入接缝。
9. 滑盖从右侧导轨入口插入，向左推闭；先轻推确认没有支撑残渣或尺寸干涉。
10. 最后旋上摄像头罩盖，后沿到止口即定位。前端距黄色圆筒安装面13，镜头从Ø16孔露出。

## 关键尺寸

- 屏幕包络330×210×20，已按用户提供的含余量尺寸建模。
- 屏幕后主机包络270×150×25，斜面及下沿接口位置仍为照片估形。
- 摄像头PCB26×19；孔距21×14，距边2.5；四个壳体通孔Ø2.6。
- 摄像头圆筒根径42、内腔36、圆形安装面厚4；灰座前端到安装面20。
- 旋盖镜头孔Ø16，前壁厚1.5，安装面到罩盖前端13。
- 旋盖后裙向后套入13.5，故罩盖单件总深度26.5，包含细筋最大外径50.65。
- 螺距2，外牙顶径44，啮合长度8，设计径向间隙0.35。

## 验证记录

八种零件均为有效单实体；STEP 重新导入及 STL 检查见 `04_核对与源文件/模型与网格检查.json`。
STL 检查包括：有限坐标、单连通、每条边恰好由两个三角形共享、相邻朝向一致、正体积和无零面积三角形。
离散网格相对 CAD 实体体积误差小于0.4%；实际结果列在 JSON 中。
CAD 检查覆盖前后框重叠、滑盖六个位置、旋盖八个位置、屏幕名义包络、板卡和摄像头通孔、下沿狭缝及筒内工具通道。

上述是数值与文件检查。未进行实物装配、打印收缩、线缆折弯、挂绳耳承载或热性能测试。
屏幕接口和后壳斜面没有新增实测数据，沿用V9确认稿的照片估算；大件打印前应让商家结合实际插头、工艺及材料复核。
成型方向、去支撑和表面处理由商家结合机器确定，本包没有预设切片、G-code 或自动分块。
