kitty-violet/efinix-romantic-camera/fpga/network/models/slot0/test-vectors/outdoor_output.png

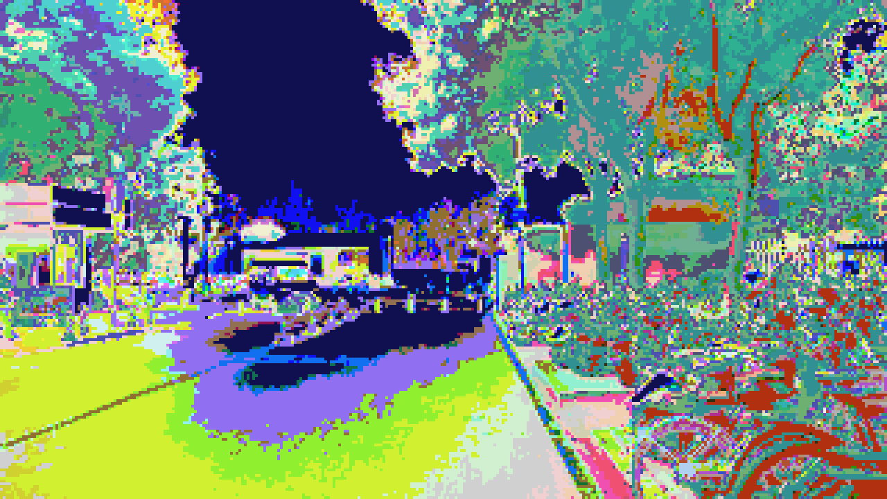
fpga/network/models/slot0/test-vectors/outdoor_output.png
