kitty-violet/efinix-romantic-camera/fpga/network/models/slot0/test-vectors/water_output.png

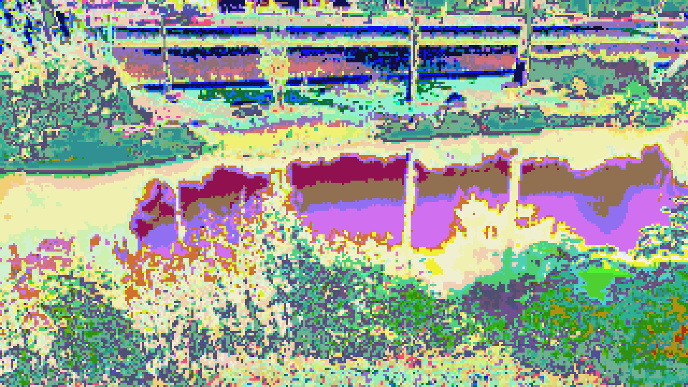
fpga/network/models/slot0/test-vectors/water_output.png
