kitty-violet/efinix-romantic-camera/fpga/network/models/slot1/test-vectors/crowd_output.png

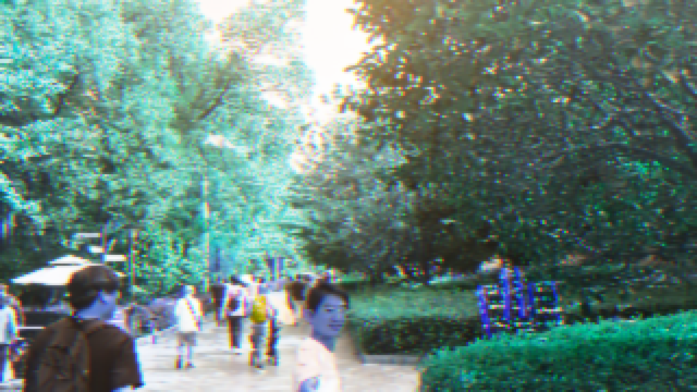
fpga/network/models/slot1/test-vectors/crowd_output.png
