kitty-violet/efinix-romantic-camera/fpga/network/models/slot1/test-vectors/indoor_output.png

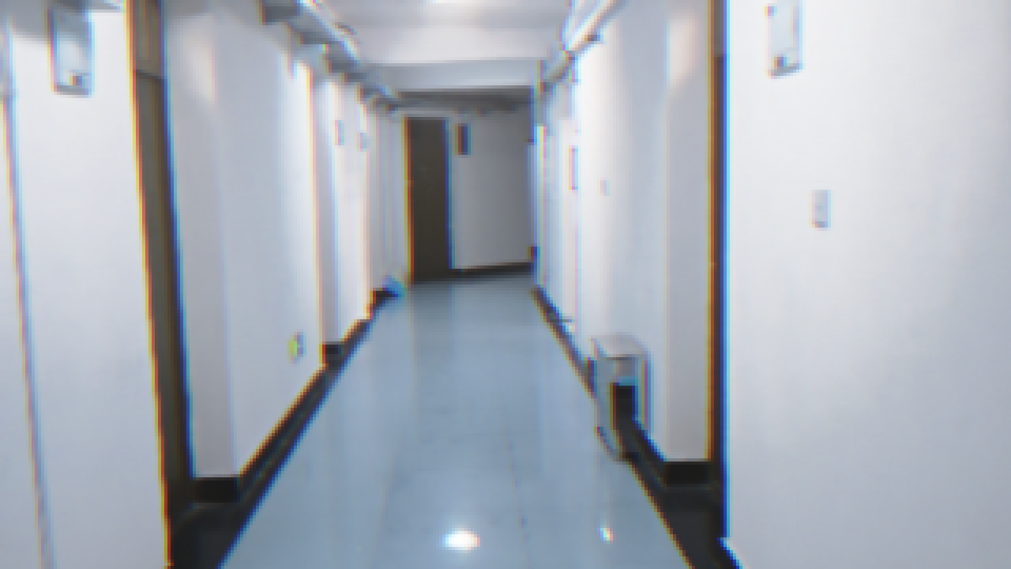
fpga/network/models/slot1/test-vectors/indoor_output.png
