kitty-violet/efinix-romantic-camera/fpga/network/models/slot1/test-vectors/water_output.png

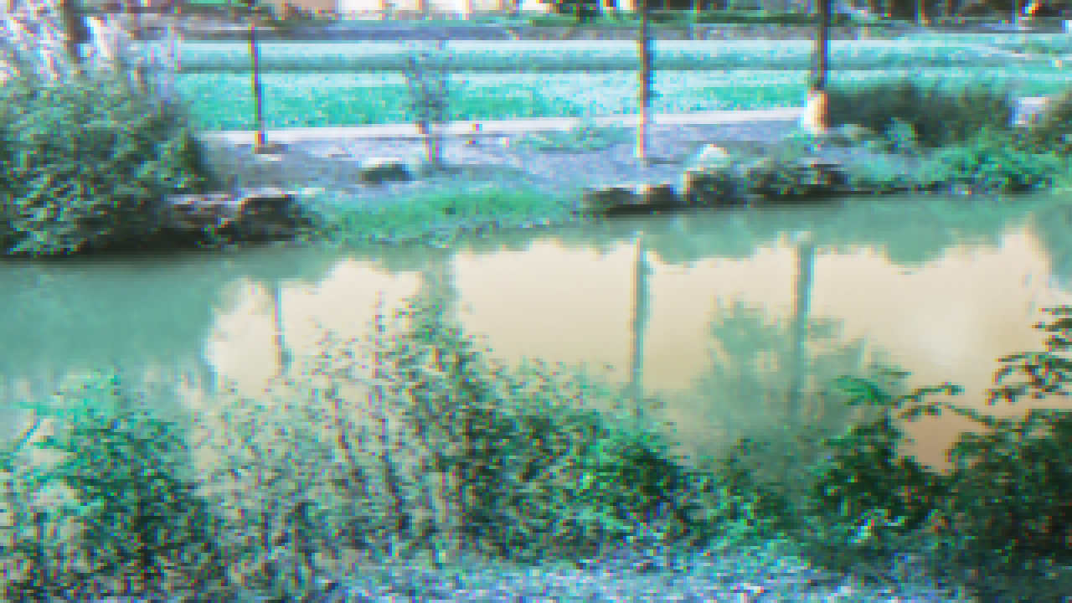
fpga/network/models/slot1/test-vectors/water_output.png
