kitty-violet/efinix-romantic-camera/fpga/network/models/slot2/test-vectors/outdoor_output.png

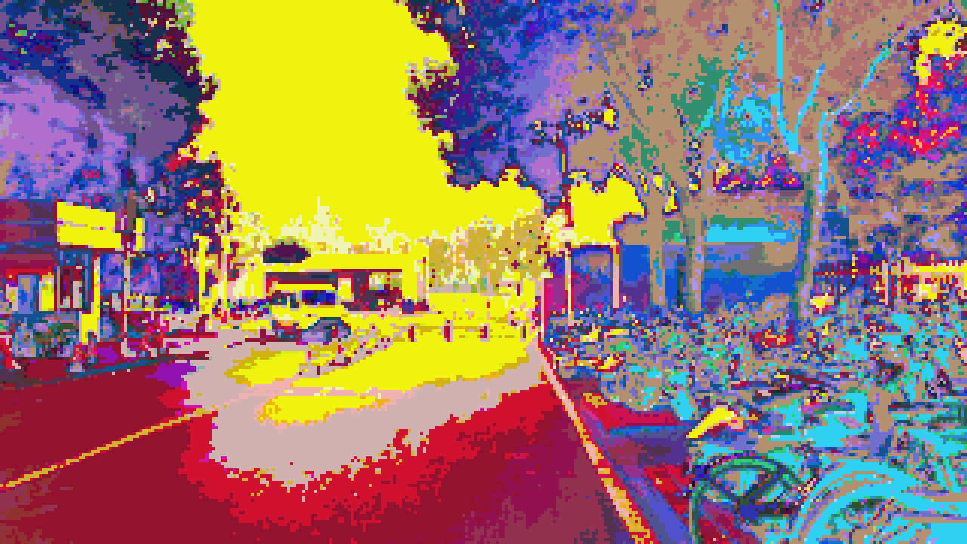
fpga/network/models/slot2/test-vectors/outdoor_output.png
