kitty-violet/efinix-romantic-camera/fpga/network/models/slot3/test-vectors/crowd_output.png

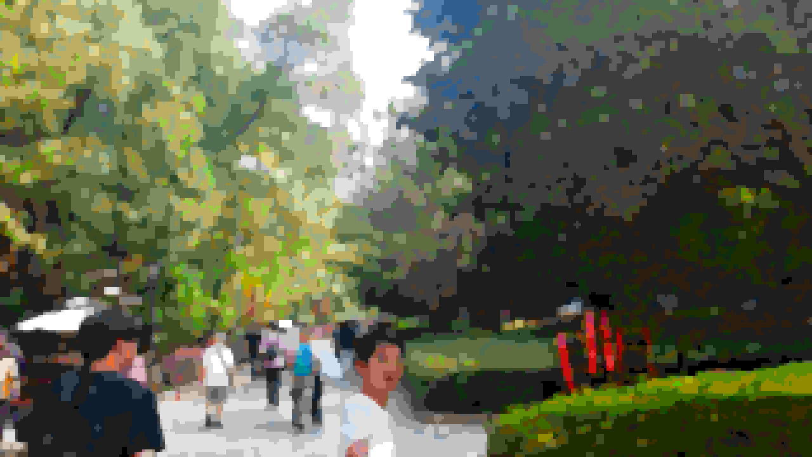
fpga/network/models/slot3/test-vectors/crowd_output.png
