kitty-violet/efinix-romantic-camera/fpga/network/models/slot3/test-vectors/water_output.png

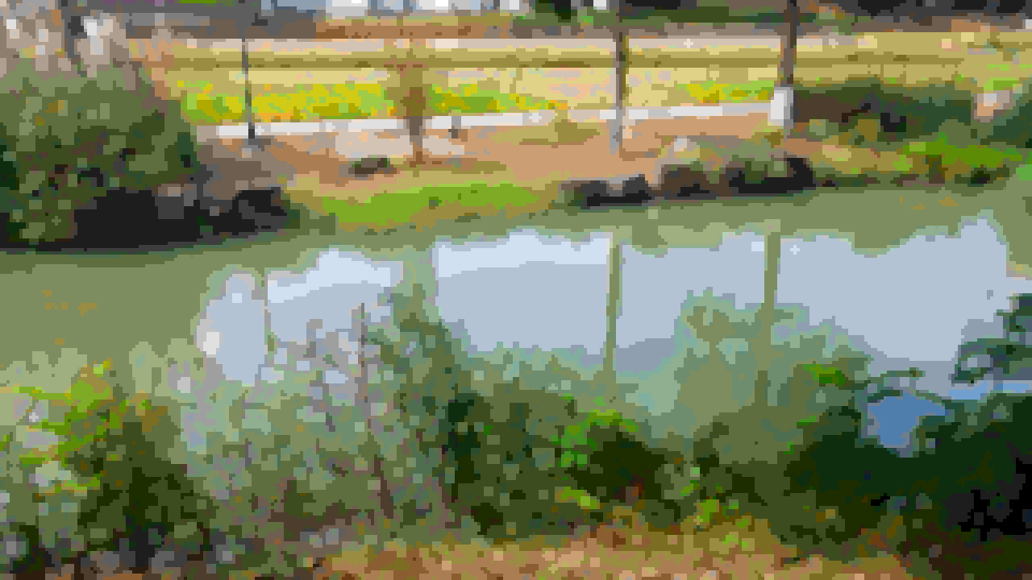
fpga/network/models/slot3/test-vectors/water_output.png
