kitty-violet/efinix-romantic-camera/fpga/network/models/slot3/user-test-vectors/photo_output.png

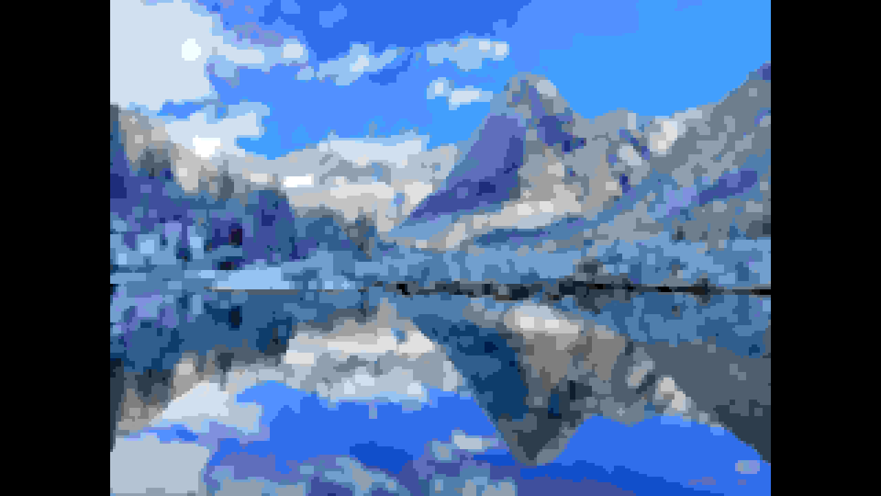
fpga/network/models/slot3/user-test-vectors/photo_output.png
