kitty-violet/efinix-romantic-camera/fpga/network/models/slot3/user-test-vectors/video_0000_output.png

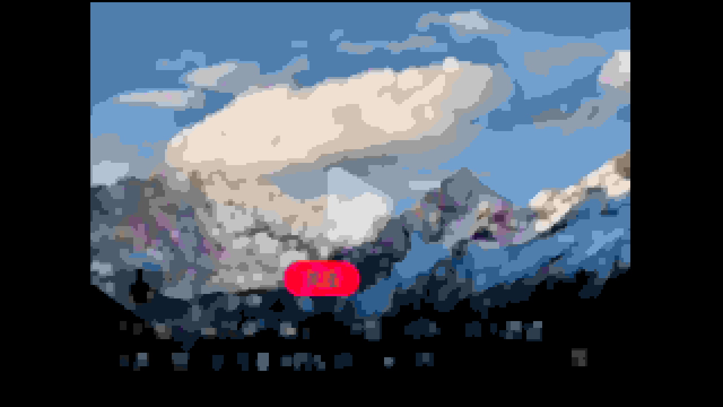
fpga/network/models/slot3/user-test-vectors/video_0000_output.png
