kitty-violet/efinix-romantic-camera/fpga/network/models/slot3/user-test-vectors/video_1072_output.png

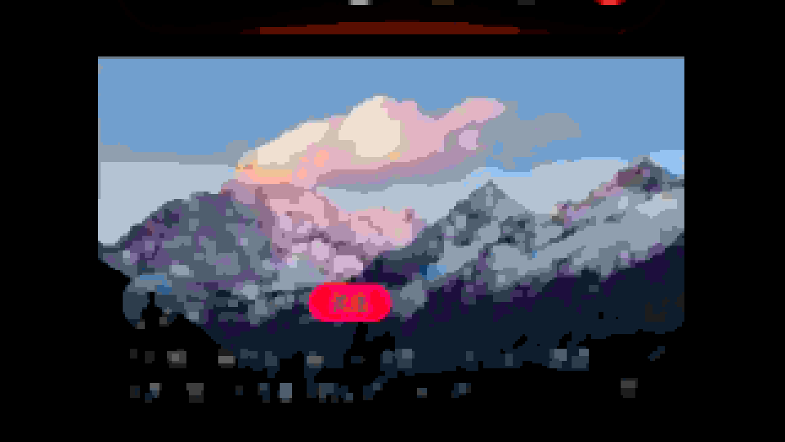
fpga/network/models/slot3/user-test-vectors/video_1072_output.png
