kitty-violet/efinix-romantic-camera/fpga/network/models/slot4/test-vectors/outdoor_output.png

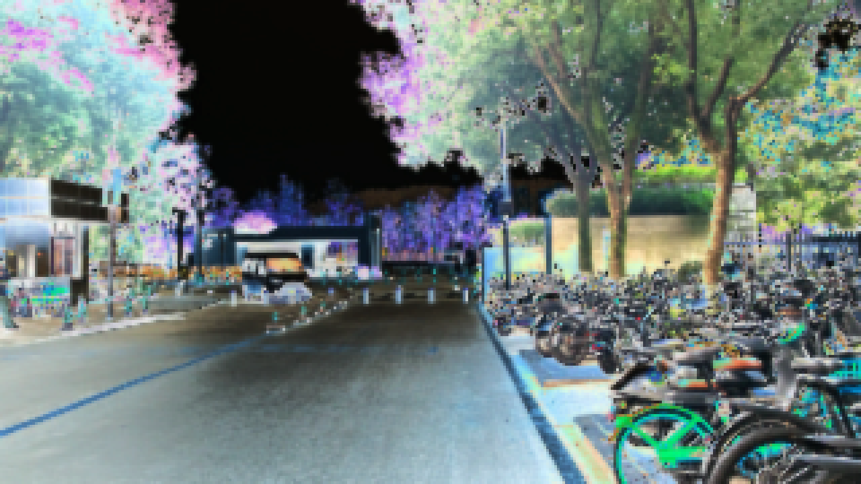
fpga/network/models/slot4/test-vectors/outdoor_output.png
