kitty-violet/efinix-romantic-camera/CHANGELOG.md

# 版本记录

## 2026-11-04 - production-r15-complete / 公开评审

- 按团队确认的 `sapphire-native8h-r15-complete-20261103.rar`更新，3240 个原包文件逐字节保留。
- 相比上一代码包新增 3151 文件，仅原 README/MANIFEST 改变；原工程、固件、网表和 34 个 V9-P1 资产不变。
- 补齐五风格 checkpoint/整数权重、S4R1 结构与参数表、42 个可读核设计源、调度/描述符、运行数据、原始开发源码与来源验证记录。
- 新增模型使用说明，更新环境、工程、使用、赛题/交接及权利文档；明确五风格加原图、720p 计算与 1080p30 显示的区别。
- 记录 Flash `0x340000` 数据区的范围及来源未板验状态；仍无最终 FPGA 位流，不将数据区 BIN 当作整片 Flash。
- 更新清单至 3274 个原始资产、323,843,953 字节，扩展自动校验和必要忽略例外。
- 按所有者要求将现有仓库改为公开供评委查阅，保留厂商原声明，不新增统一开源授权。
- 本轮不安装工具、不改 HDL/C/权重、不训练、不执行综合/HDL 仿真或板上烧录。

## 2026-11-03 - production-r15

- 使用 `sapphire-native8h-r15-code-20261103.zip` 更新 FPGA 目录，89 个包内文件逐字节保留。
- 新增 Sapphire RISC-V 控制面、C 固件、预编译 ELF/BIN/ROM、Efinity XML/外设/SDC、六模式相关逻辑、测试台与配置。
- 大网表改为 `fpga/project/native222.v` 并继续使用 Git LFS；保留必需的 project/outflow、ROM 和测试 HEX，补齐忽略规则例外。
- 更新项目、环境、使用、协议、赛题对照及交接文档，撤下当前版本“无 RISC-V、缺工程配置”的旧描述；不把旧 17.1 AI FPS 当作 r15 测量。
- 更新资产清单及自动检查，增加原包清单、工程引用和 CPU ROM 一致性验证。
- V9-P1 的 34 个原始资产未改变；旧 FPGA 代码仍可在提交 `423d07a` 查阅。
- 本次不安装软件、不改 HDL/C 逻辑、不执行综合、仿真或板上烧录。

## 2026-11-02 - 首次私有仓库归档

- 收录 `legacy222-ble-five-cn-20261101-ble5` 的四个 HDL 文件和原始说明，未修改其内容。
- 收录 V9-P1 正式打印件、试配环、装配 STEP、CAD 源码、参数和关键历史报告。
- 添加中文项目说明、环境与获取方式、使用说明、蓝牙协议、打印入口、赛题对照和交接文档。
- 大网表与 CAD/网格使用 Git LFS，添加来源资产清单、完整性脚本及 GitHub Actions。
- 明确当前无 RISC-V、缺完整 Efinity 工程与位流；本次不执行逻辑修改、综合、重新训练或实物测试。

## 来源版本

| 来源 | 版本/日期 |
| --- | --- |
| 当前 FPGA 包 | `production-r15-complete`，原包 2026-11-03，入库 2026-11-04 |
| 上一 FPGA 代码包 | `production-r15`，2026-11-03，提交 `d622db6` |
| 历史 FPGA 说明 | `legacy222-ble-five-cn-20261101-ble5`，提交 `423d07a` |
| 网表工具属性 | Efinity `2026.1.132` |
| 外壳原交付 | V9-P1，2026-10-28 |
