kitty-violet/efinix-romantic-camera/fpga/original_sources/frame_execution/package_video_service_joint_control.py

"""Guarded A-zero source, numerical/cache checks and unchanged full release gates."""
from pathlib import Path
source=Path(__file__).with_name('package_video_service_data_reset.py');code=source.read_text()
# Push the scope into the final README and manifest before their hashes and
# the programmer binding are made. Parent release scripts remain unchanged.
scope_changes=[
 ('- A系数、compute、DMA为已验收集成包；包内*.bin用于硬件装载，不用.pt文件。',
  '- A系数、compute、DMA为已验收集成包；包内*.bin用于硬件装载，不用.pt文件。\n- 本实现按当前A系数的恒零位精简缓存；不改变A系数或B1算术。装入不满足零位约束的系数将触发既有werror并停止，不能据此宣称任意其他权重兼容。'),
 ('native=str(native),board=str(board),',
  "coefficient_policy=dict(id='guarded-A-zero-v1',package_sha256=inventory['package_sha256'],guarded_zero_masks=inventory['guard_masks'],unsupported_nonzero='sticky cache error, compute inhibited'),native=str(native),board=str(board),"),
]
anchor="source=Path(__file__).with_name('package_video_service_rq.py');code=source.read_text()"
assert code.count(anchor)==1
insertion='changes = [\n'+''.join(' '+repr(pair)+',\n' for pair in scope_changes)
code=code.replace(anchor,anchor+".replace('from place_video_service_rq import audit_delta','from place_video_service_shared_frontier import audit_delta')"+'\nassert code.count("changes = [")==1\ncode=code.replace("changes = [",'+repr(insertion)+')')
changes=[('video-service-native42-data-reset-only', 'video-service-native64-joint-control'), ('video-service-mapped-boot21-data-reset', 'video-service-mapped-boot39-joint-control'), ('video-service-owner-boundary8-data-reset', 'video-service-owner-boundary28-joint-control'), ('video-service-data-reset-mapped-transport1', 'video-service-joint-control-mapped-transport1'), ('video-service-data-reset-fixture1', 'video-service-joint-control-fixture1'), ('video-service-data-reset-mapped1', 'video-service-joint-control-data-reset-mapped1'), (" receipt=bind(native/'data-reset-edit.json')", " assert ng['weight_zero_removed']==246 and ng['weight_zero_guard_luts']==91\n weight_parent=Path(ng['weight_zero_parent']);assert weight_parent.name=='video-service-native42-data-reset-only'\n edit=bind(native/'weight-zero-edit.json');assert edit['latency_added']==0 and Path(edit['parent'])==weight_parent\n assert edit['source_sha256']==sha(weight_parent/'native_source.v')\n independent=bind(native/'weight-zero-independent-audit.json')\n assert independent['status']=='GUARDED_A_ZERO_EXACT_SOURCE_GRAPH_PASS_NOT_PHYSICAL'\n assert independent['source_sha256']==sha(native/'native_source.v') and independent['joint_control_proof']==str(native/'joint-control-independent-audit.json')\n file_map(independent['inputs'])\n current=bind(native/'joint-control-independent-audit.json')\n assert current['status']=='JOINT_CONTROL_COMPOSITIONAL_CEC_PASS_NOT_PHYSICAL' and current['source_sha256']==sha(native/'native_source.v')\n assert current['all_original_sequential_state_exact'] and current['ports_protected_assigns_exact'] and current['extra_cycles']==0\n assert current['all_boolean_inputs'] and current['tampered_output_rejected'] and current['address_projection_induction'] and current['address_projection_ffs']==32\n assert current['all_boundary_inputs']==505 and current['all_exposed_outputs']==48\n file_map(current['inputs']);current_edit=bind(native/'joint-control-edit.json');file_map(current_edit['inputs'])\n parent63=ROOT/'tmp/frame-execution/video-service-native63c-shared-frontier'\n assert current['parent_sha256']==sha(parent63/'native_source.v') and Path(current_edit['parent'])==parent63\n historical=bind(ROOT/'tmp/board-test/video-service-review1/current-functional-shared-frontier-1.json')\n assert historical['status']=='CURRENT_SERVICE_FUNCTIONAL_RELEASE_INPUTS_CHECKED_NOT_PHYSICAL_RELEASE';file_map(historical['evidence'])\n # The unchanged prior numerical/carry/APB proofs compose through the independently checked complete64 delta.\n for label,status in [('video-service64-source-delta1','ACTUAL_VENDOR_JOINT_CONTROL_CUT_PASS'),('video-service64-address-replay2','ACTUAL_VENDOR_ADDRESS_PROJECTION_PASS'),('video-service64-mapped-delta1','ACTUAL_VENDOR_JOINT_CONTROL_ALL_CHANGED_LUTS_MAP_PASS')]:\n  root=ROOT/'tmp/frame-execution'/label;rr=bind(root/'result.json');assert rr['status']==status and rr['source_sha256']==sha(native/'native_source.v')\n  file_map(bind(root/'inputs.json',rr['inputs_sha256']))\n  for f in root.glob('*.log'):bind(f)\n  if label.endswith('source-delta1'):assert rr['comparisons']==245184 and rr['vectors']==5108 and rr['outputs']==48\n  elif 'address-replay' in label:assert rr['comparisons']==1280096 and rr['resets']==102 and rr['extra_cycles']==0\n  else:assert rr['map_sha256']==sha(mapped) and rr['four_state_cases_per_lut']==256 and rr['pruned_luts_four_state_proof']['all_aliases_four_state_proved']\n synt=bind(ROOT/'tmp/frame-execution/video-service64-syntax1/result.json');assert synt['status']=='ACTUAL_OPEN_VERILOG_SYNTAX_PASS_NOT_IP_ELABORATION';file_map(synt['inputs'])\n for name in ('audit_video_service_joint_control.py','validate_video_service_joint_control.py','validate_video_service_address_projection.py','audit_video_service_joint_control_warnings.py','check_video_service_joint_control_map.py','audit_video_service_shared_frontier_map.py','shared_frontier_map_aliases.py','place_video_service_shared_frontier.py','validate_video_service_joint_control_map.py','validate_video_service_joint_control_pages.py','joint_control_observation_binding.py','validate_video_service_same_edge_pages.py','validate_video_service_narrow_mapped_pages.py','validate_video_service_compact_mapped_pages.py'):bind(HERE/name)\n pg=bind(board/'pages-proof.json');ab=pg['apb_observation_binding'];assert pg['checker_sha256']==sha(HERE/'validate_video_service_joint_control_pages.py')\n assert ab['legal_reset_same_edge_equivalence'] and ab['cycles_added']==0 and ab['current_cell']=='SERVICE62_APB_ENABLE';file_map(ab['evidence'])\n ob=bind(ROOT/'tmp/frame-execution/video-service-owner-boundary28-joint-control/current-binding.json')\n assert ob['status']=='CURRENT_PROVED_NATIVE_PORT_BINDING' and ob['map_sha256']==sha(mapped) and ob['source_sha256']==sha(native/'native_source.v')\n bind(HERE/'validate_video_service_owner_boundary_v2.py',ob['checker_sha256']);bind(HERE/'validate_video_service_owner_boundary.py',ob['parent_checker_sha256'])\n sp=bind(board/'status-selection-proof.json');assert sp['front_bank_alias_proof']['reset_inductive_state_alias'] and sp['front_bank_alias_proof']['all_non_output_pins_identical'] and sp['front_bank_alias_proof']['all_parameters_identical']\n bind(HERE/'validate_video_service_joint_control_status.py',sp['checker_sha256']);file_map(sp['inputs'])\n sab=sp['apb_observation_binding'];assert sab['old_observation_cone_boolean_cases']==2048 and sab['legal_onehot_cases']==20 and sab['old_state_boundary_identical'] and sab['legal_reset_same_edge_equivalence'] and sab['cycles_added']==0;file_map(sab['evidence'])\n dab=sp['address_observation_binding'];assert dab['projected_ff_count']==32 and dab['extra_cycles']==0 and dab['status']=='OBSERVATION_BOUNDARY_NORMALIZED_ONLY_AFTER_SAME_EDGE_PROOF';file_map(dab['evidence'])\n inventory=bind(native/'a-zero-inventory.json');assert inventory['status']=='ACTUAL_A_PACKED_LOADER_ZERO_BITS_VERIFIED' and inventory['byte_order_checks']==11232 and inventory['removed_storage']==246\n ow=bind(ROOT/'tmp/frame-execution/video-service-owner-boundary28-joint-control/warning-port-audit.json');assert ow['status']=='EVERY_MISSING_PORT_UNUSED_OUTPUT_OR_BOOLEAN_INDEPENDENT_INPUT_PASS';file_map(ow['evidence'])\n for script in ('validate_video_service_weight_zero_factored.py','validate_video_service_weight_zero_data_reset.py','validate_video_service_weight_data_reset.py','audit_video_service_weight_zero_map.py','audit_video_service_weight_zero_map_v2.py','package_video_service_data_reset.py'):bind(HERE/script)\n receipt=bind(weight_parent/'data-reset-edit.json')")]
for old,new in changes:
 assert old in code,old
 code=code.replace(old,new)
needle='for old,new in changes:';assert code.count(needle)==1
code=code.replace(needle,'changes.append(("assert ng[\'retained_primitives\']==54577", "assert ng[\'retained_primitives\']==54243"))\n'+needle)
exec(compile(code,str(source)+':guarded-a-zero-profile','exec'),globals())
