kitty-violet/efinix-romantic-camera/fpga/original_sources/frame_execution/cnn_sparse_control_implementation.py

from cnn_sparse_control_board import audit_delta
import audit_camera_implementation as prior
prior.scope['audit_delta']=audit_delta

def audit(board,physical=None):
    return prior.audit(board,physical)
