kitty-violet/efinix-romantic-camera/fpga/original_sources/frame_execution/fault_probe_board.py

"""Read-only first-adapter-fault and DDR clock/reset probe on the proven CPU.

All differences are reversible, explicitly generated, and checked against the
frozen complete-transition2 source. Existing functional statements stay intact.
"""
import argparse,json,shutil
from pathlib import Path
from run_units import ROOT,HERE,sha
from complete_control_transition import audit_delta as audit_parent
BASE=ROOT/'tmp/frame-execution/connected-board-complete-transition2'
CLOCK=HERE/'variants/board_fault_probe/bringup_clock_probe.sv'
PROBE_PORT='    output wire [127:0] adapter_diagnostic,\n'

def one(text,before,after):
 assert text.count(before)==1,(before,text.count(before))
 return text.replace(before,after)

def adapter(text):
 text=one(text,'    input wire clk, input wire rst_n,',PROBE_PORT+'    input wire clk, input wire rst_n,')
 observe=r'''
    // Independent observer: retain the PRECEDING cycle when either real
    // sticky error FF first asserts. Do not infer a cause from the OR alone.
    wire [31:0] probe_live={s_axi_wready,m_axi_arready,m_axi_awready,
        (wremaining==1),s_axi_bready,s_axi_rready,(m_axi_bid!=0),(m_axi_rid!=0),
        m_axi_bresp,m_axi_rresp,s_axi_wstrb,s_axi_wlast,m_axi_rlast,
        m_axi_bvalid,m_axi_rvalid,s_axi_wvalid,s_axi_awvalid,s_axi_arvalid,
        rst_n,werror,rerror,wstate,rstate};
    reg [31:0] probe_previous=0,probe_address=0;
    reg [23:0] probe_ticks=0;
    reg [95:0] probe_first=0;
    always @(posedge clk)begin
        if(!rst_n)begin
            probe_previous<=0;probe_address<=0;probe_ticks<=0;probe_first<=0;
        end else begin
            probe_ticks<=probe_ticks+1'b1;
            probe_previous<=probe_live;
            probe_address<=s_axi_arvalid ? s_axi_araddr :
                s_axi_awvalid ? s_axi_awaddr : rstate!=R_IDLE ? raddr : waddr;
            if(!probe_first[95] && (rerror || werror))
                probe_first<={1'b1,5'd0,werror,rerror,probe_ticks,probe_address,probe_previous};
        end
    end
    assign adapter_diagnostic={probe_live,probe_first};
'''
 return one(text,'endmodule',observe+'\nendmodule')
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
