kitty-violet/efinix-romantic-camera/(commit log)

2026-11-02 Archive romantic camera FPGA code and V9 enclosure with Chinese guides
    [01_front_frame_grip.stl, 01_front_frame_grip.stp, 02_rear_case_camera.stl, 02_rear_case_camera.stp, 03_sliding_lid.stl, 03_sliding_lid.stp, 04_camera_screw_cap.stl, 04_camera_screw_cap.stp]
2026-11-03 Update camera to Sapphire native8h production-r15
    [ti60f225_oob.interface.csv, ti60f225_oob.pinout.csv]
